rhitvik/Magnetic_Field_Pulse_Generator/Consideraton_Report_for_IC_LT8613/Simulation_Report_L&8613/Rhitvik Simulation report on LT8613.pdf

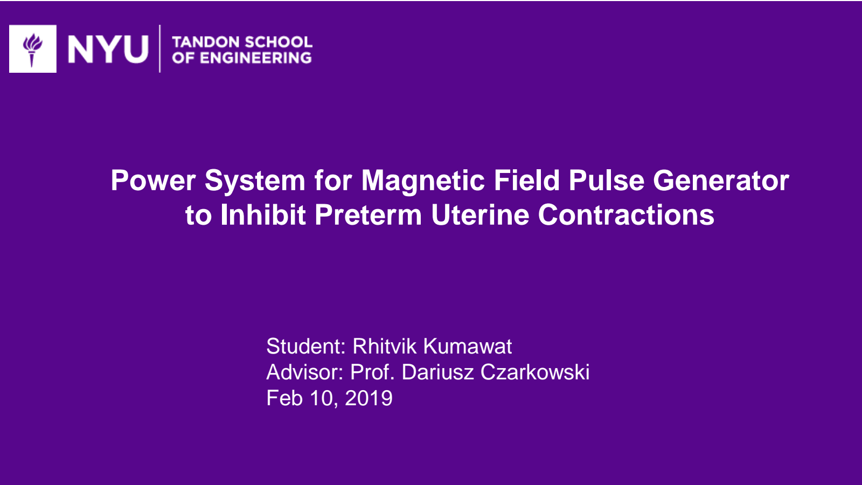
[picture p13: page 1]

# Power System for Magnetic Field Pulse Generator to Inhibit Preterm Uterine Contractions

## Student: Rhitvik Kumawat Advisor: Prof. Dariusz Czarkowski Feb 10, 2019

Basic Idea of Our Design

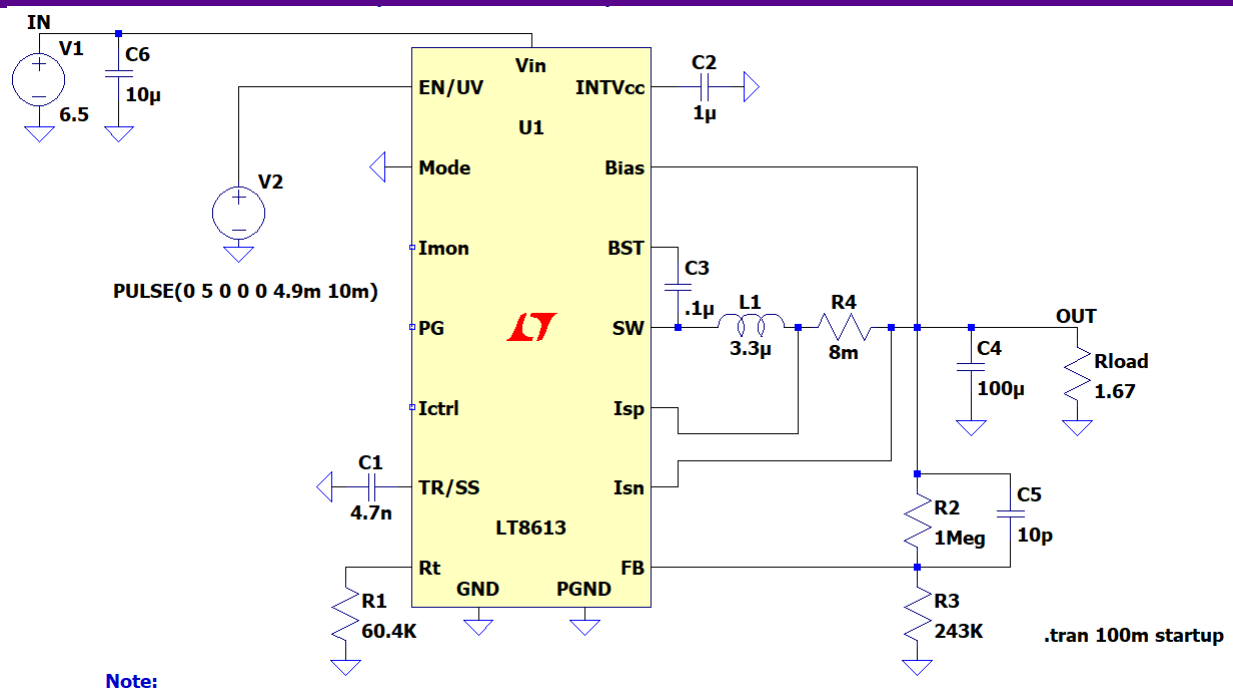
[picture p14: figure]

This is the IC configuration can be employed for our converter if we decide to go with LT8613

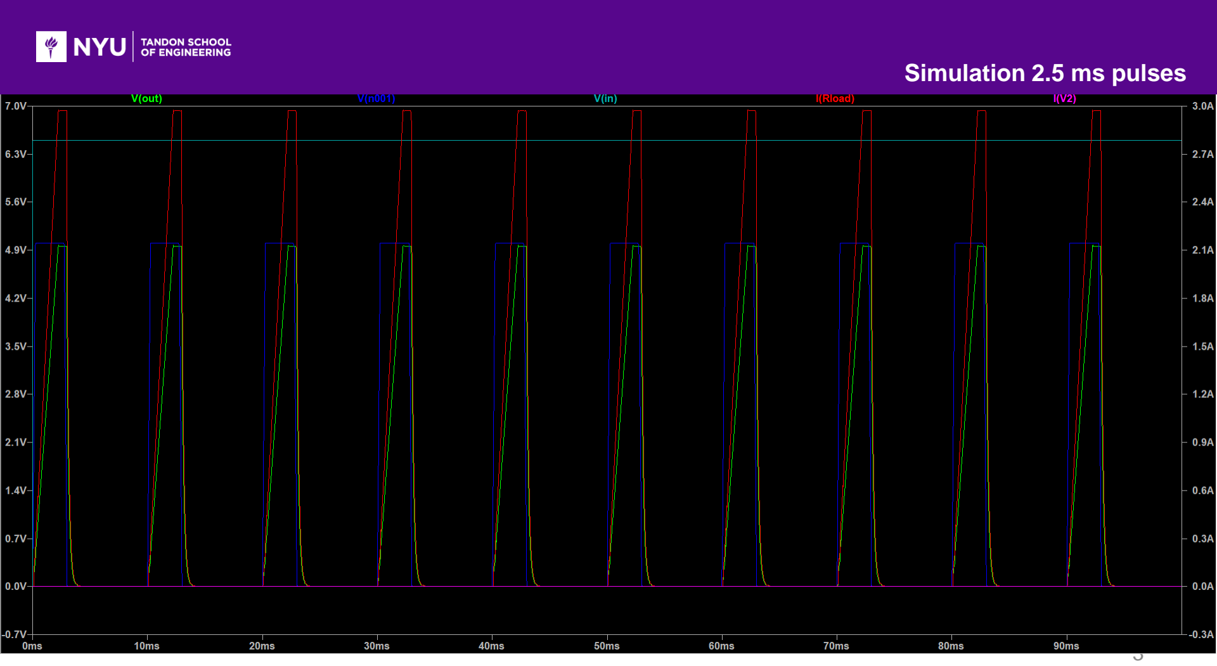
[picture p15: page 3]

Simulation 2.5 ms pulses

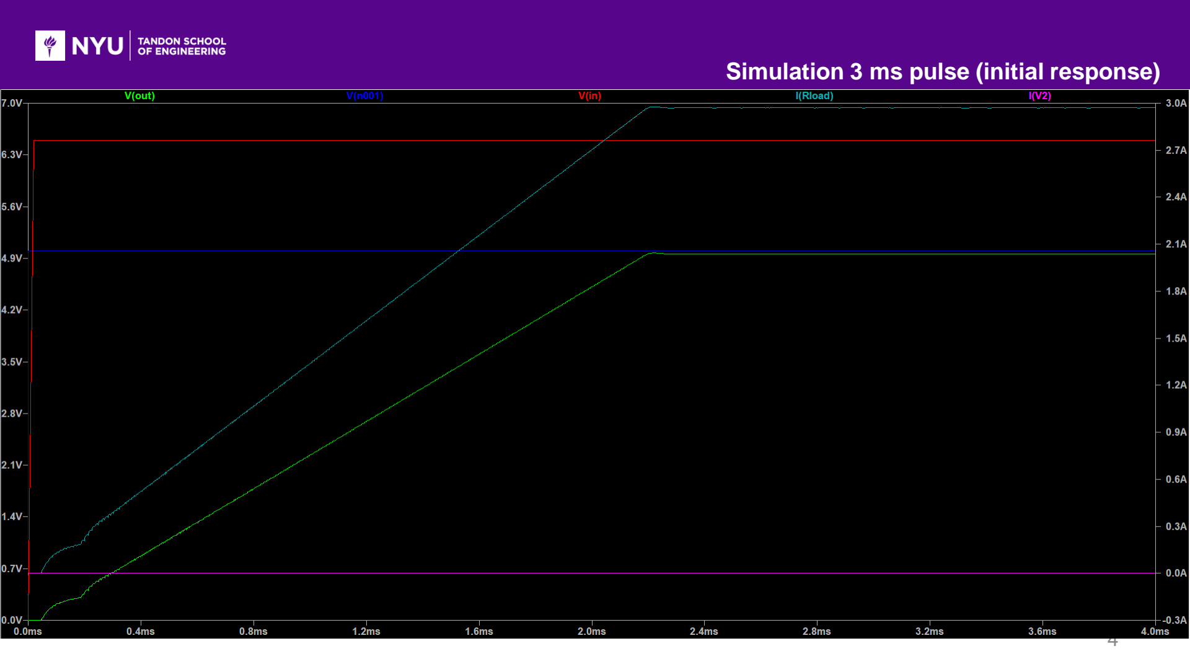
[picture p16: page 4]

Simulation 3 ms pulse (initial response)

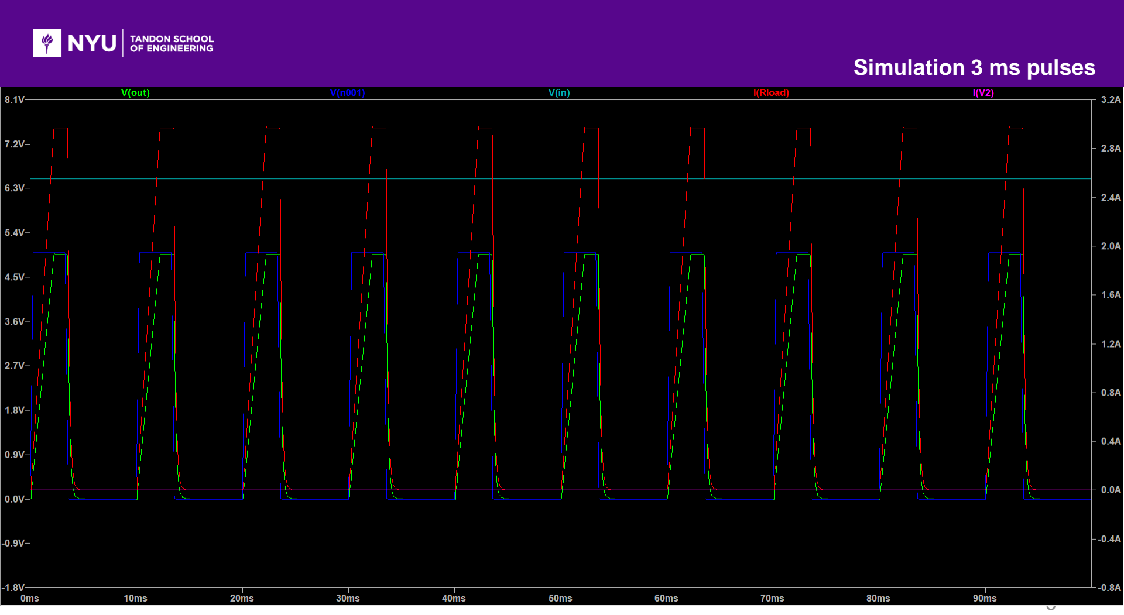
[picture p17: page 5]

Simulation 3 ms pulses

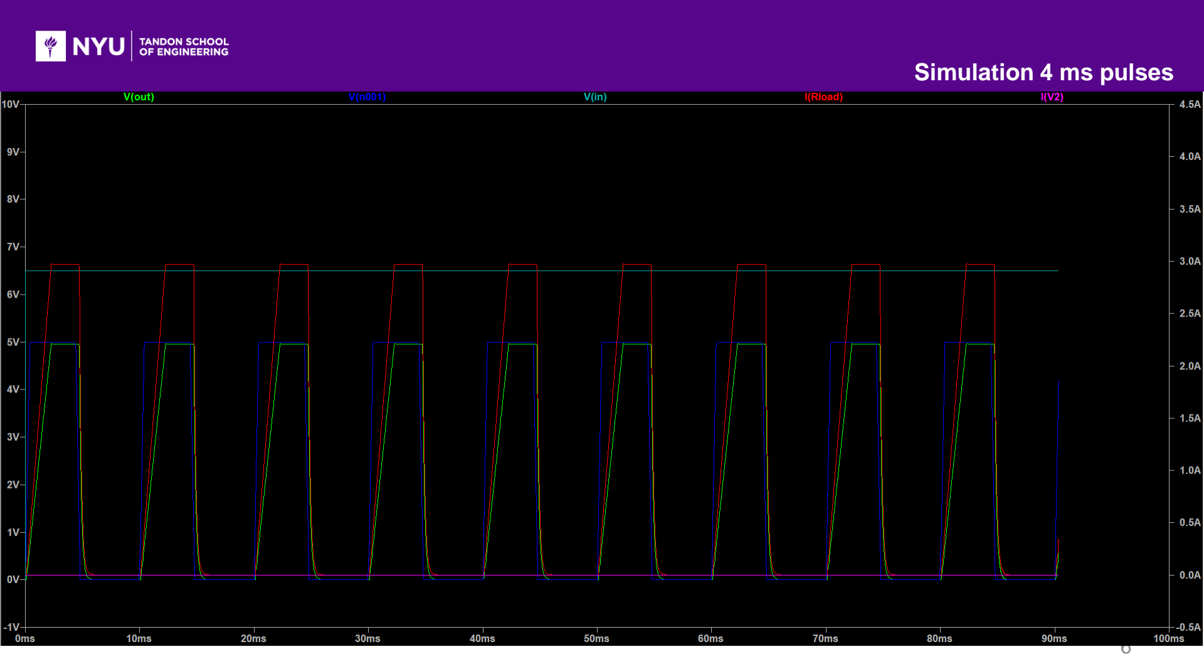
[picture p18: page 6]

Simulation 4 ms pulses

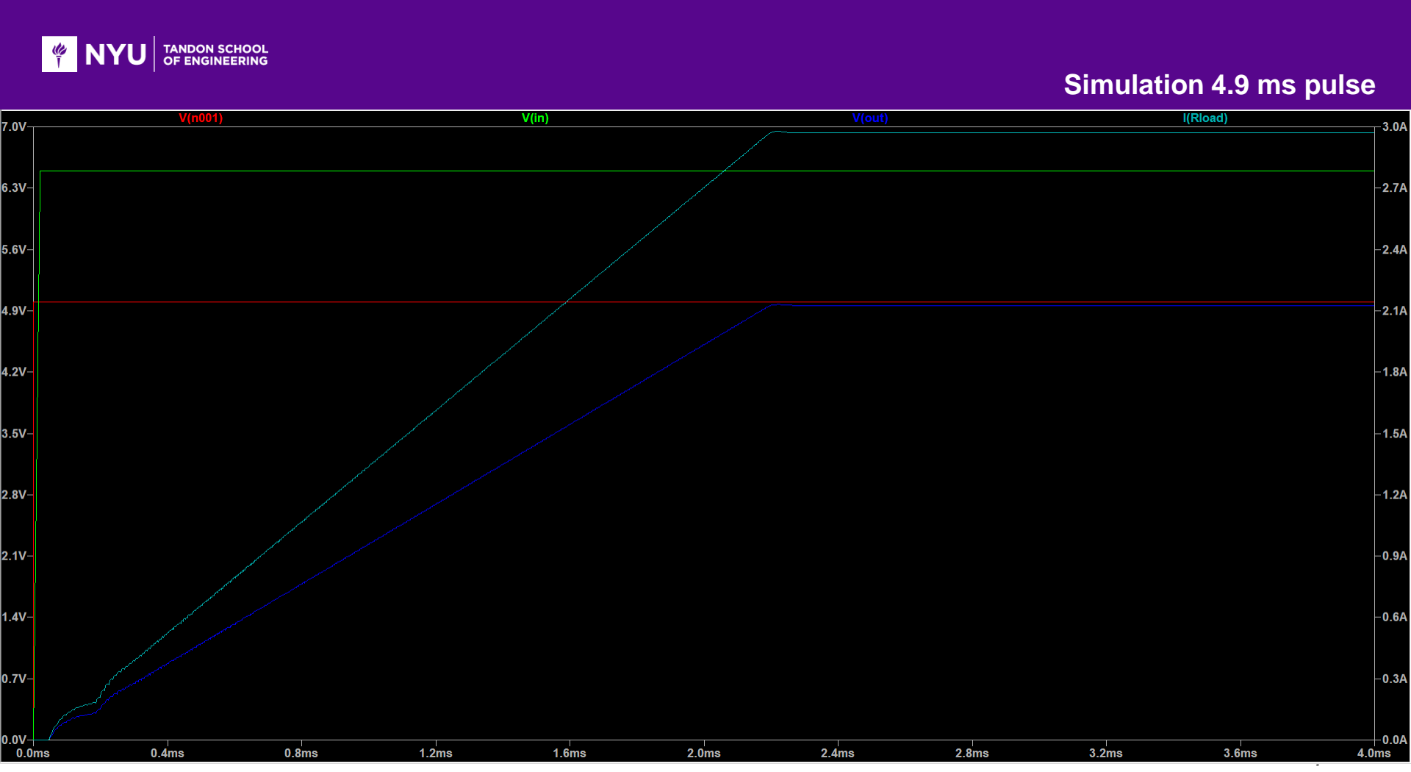
[picture p19: page 7]

Simulation 4.9 ms pulse

# End of Presentation Thank you
