rhitvik/Magnetic_Field_Pulse_Generator/Consideraton_Report_for_IC_LT8613/Images_and_Screeenshots/20171227142412_99787.png

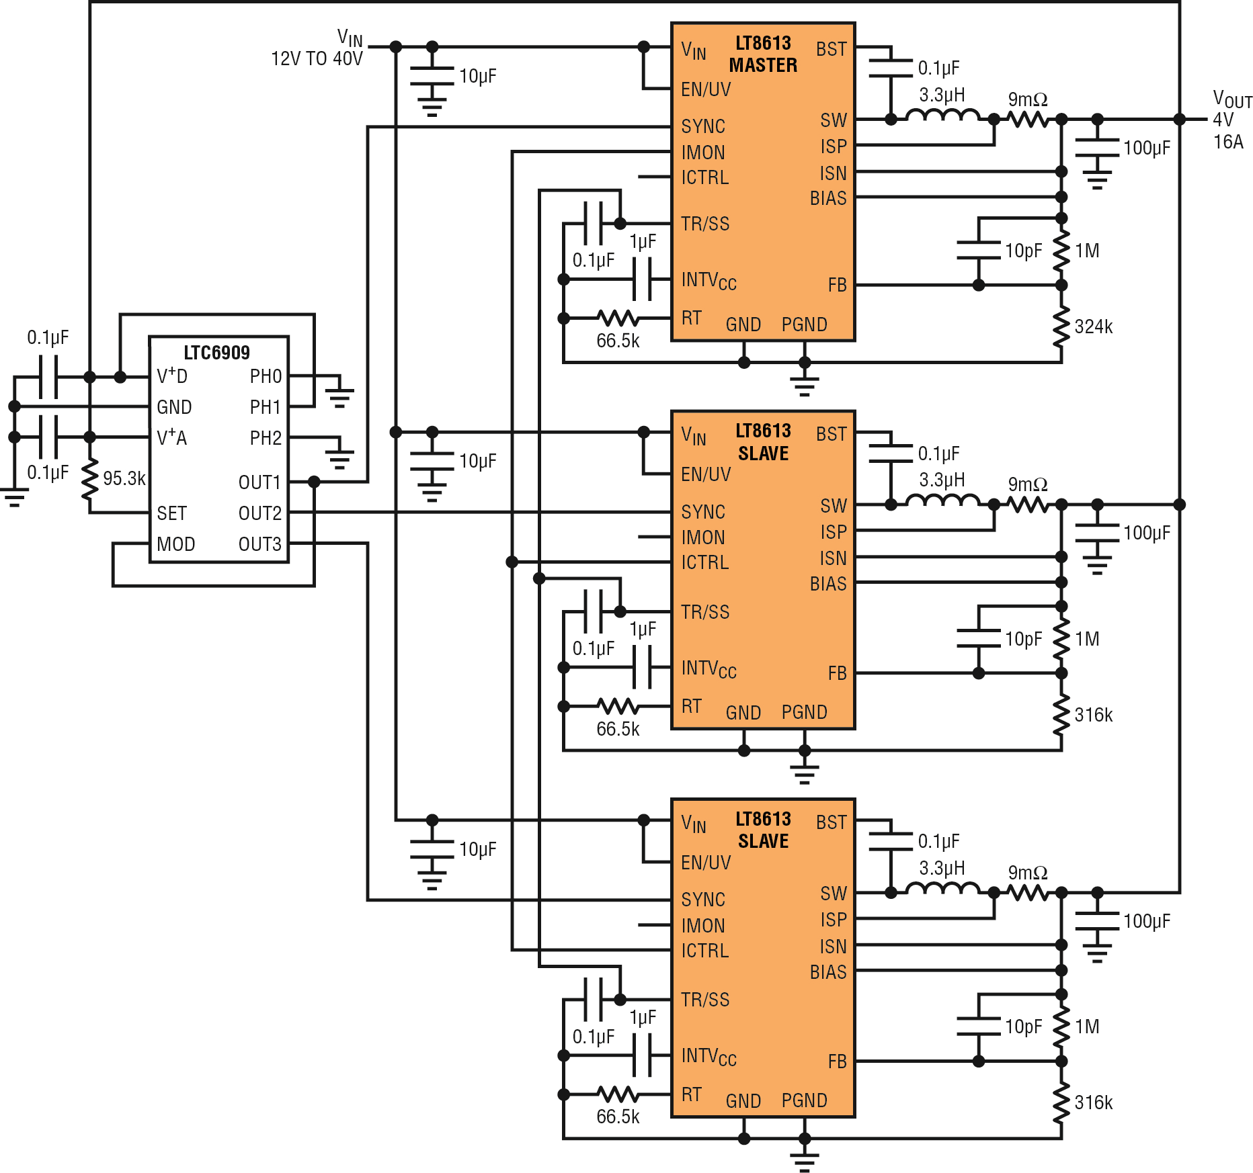
Consideraton_Report_for_IC_LT8613/Images_and_Screeenshots/20171227142412_99787.png
