rhitvik/Magnetic_Field_Pulse_Generator/Consideraton_Report_for_IC_LT8613/Images_and_Screeenshots/LT8613-32051.png

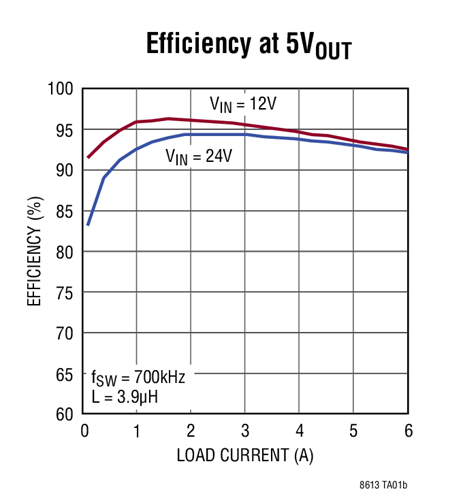
Consideraton_Report_for_IC_LT8613/Images_and_Screeenshots/LT8613-32051.png
