rhitvik/Magnetic_Field_Pulse_Generator/Images_and_Screenshots/Completed_Prototype.jpg

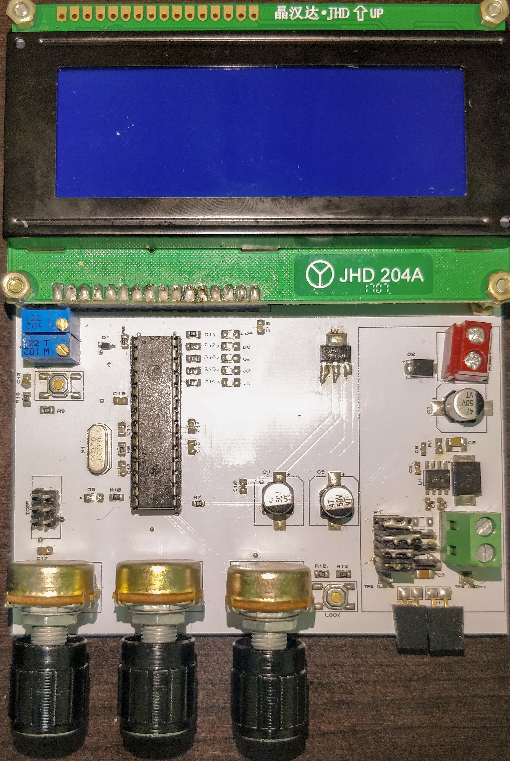
Images_and_Screenshots/Completed_Prototype.jpg
