rhitvik/Magnetic_Field_Pulse_Generator/Images_and_Screenshots/Obtained waveform.jpg

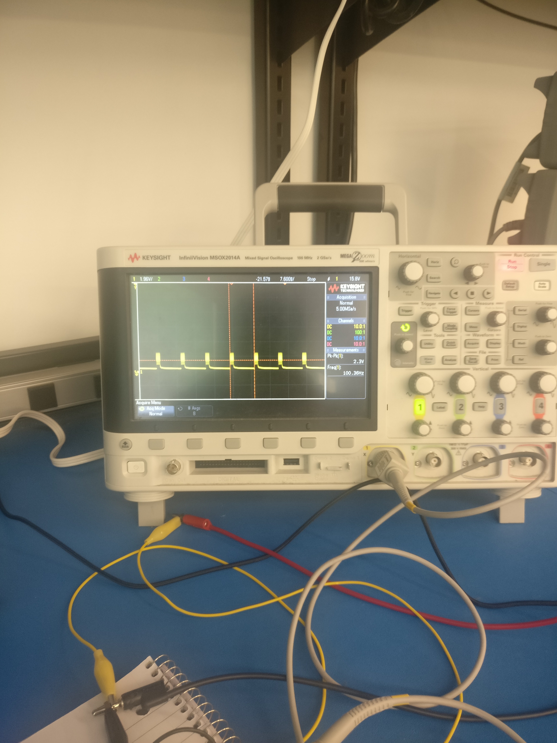
Images_and_Screenshots/Obtained waveform.jpg
