rhitvik/Magnetic_Field_Pulse_Generator/Images_and_Screenshots/PCB_for_the_Pulse_Generator.jpg

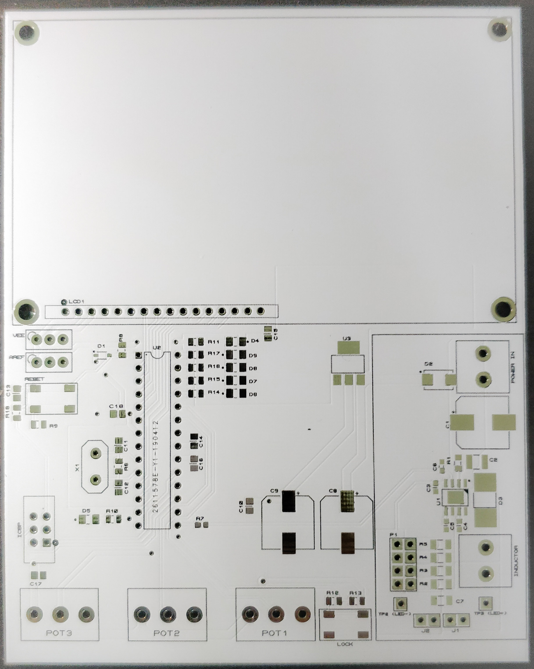
Images_and_Screenshots/PCB_for_the_Pulse_Generator.jpg
