rhitvik/Magnetic_Field_Pulse_Generator/Images_and_Screenshots/PSX_20190528_235512.jpg

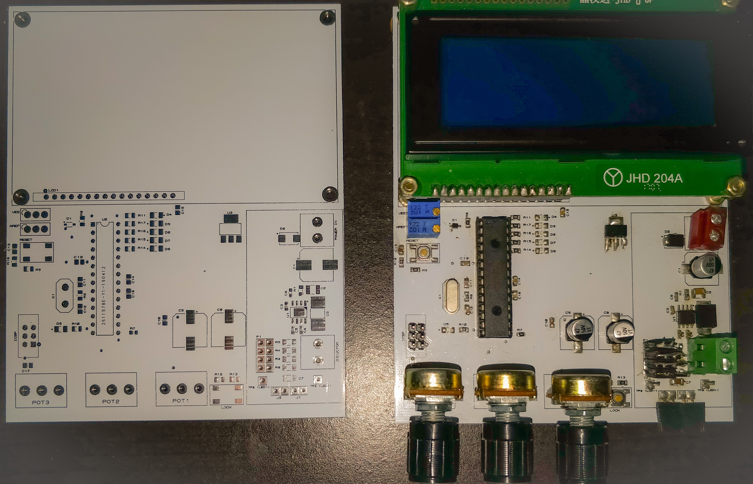
Images_and_Screenshots/PSX_20190528_235512.jpg
