rhitvik/Magnetic_Field_Pulse_Generator/Images_and_Screenshots/PSX_20190529_000846.jpg

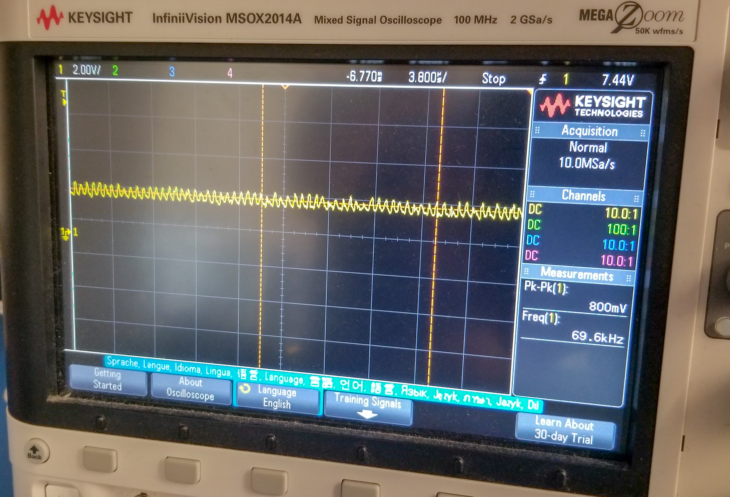
Images_and_Screenshots/PSX_20190529_000846.jpg
