rhitvik/Magnetic_Field_Pulse_Generator/Images_and_Screenshots/PSX_20190529_001306.jpg

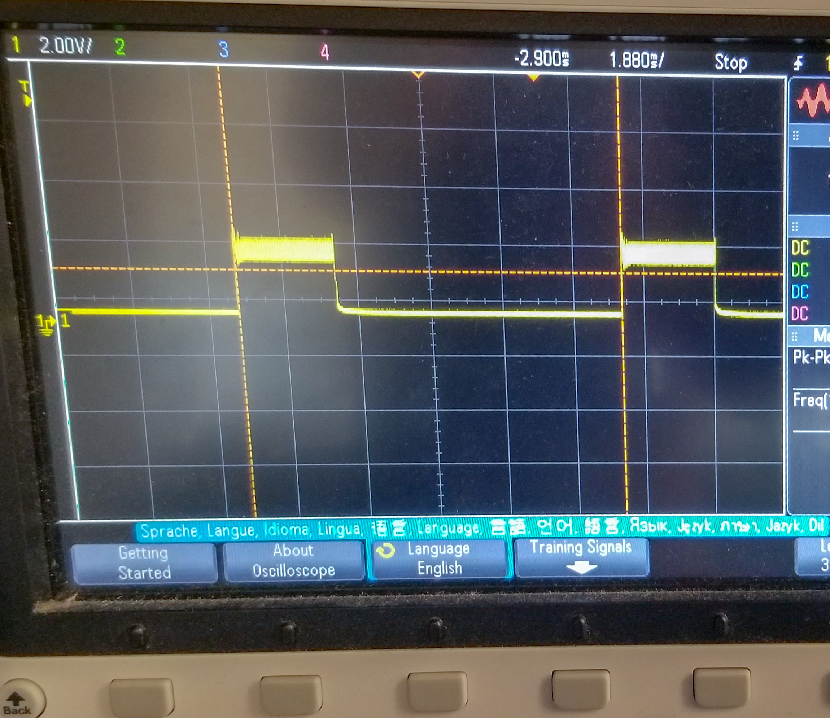
Images_and_Screenshots/PSX_20190529_001306.jpg
