rhitvik/Magnetic_Field_Pulse_Generator/Images_and_Screenshots/PSX_20190614_192414.jpg

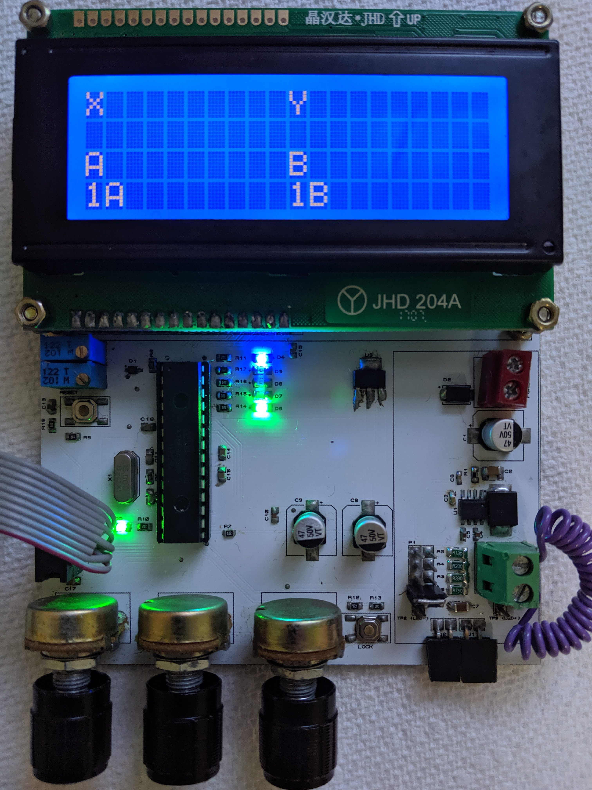
Images_and_Screenshots/PSX_20190614_192414.jpg
