rhitvik/Magnetic_Field_Pulse_Generator/Bill_of_materials/BOM - Revised.xlsx

Revision | 1
Design Created | 2019-03-28
Design Last Modified | 2019-04-07
Total Parts In Design | 65
0 Modules
Quantity | References | Value | Stock Code |  | Unit Cost
18 Capacitors
Quantity | References | Value | Stock Code | status | Unit Cost
3 | C1,C8,C9 | 47u |  | Delivered | 145 Pcs SMD Capacitors Assorted Box Kit $11.99 | https://www.amazon.com/Capacitors-Assorted-Values-Electrolytic-Assortment/dp/B0778LX66Z?s=gateway
1 | C2 | 1000pF | Digikey 478-1589-1-ND | Ordered | McIgIcM 1206 SMD Capacitor,16values20pcs=320pcs $15.99 | https://www.amazon.com/McIgIcM-16values20pcs-Electronic-Multiplayer-Capacitors/dp/B06XDHC93D?s=gateway
1 | C3 | 0.1u | Digikey C1608X7R1C104K/10-ND | Delivered | 90 Value x 50pcs = 4500pcs SMD $35.99 | https://www.amazon.com/WINGONEER-Capacitor-0-5pF-2-2uF-4500pcs-Sample/dp/B072FNVRKP?s=gateway
1 | C4 | 0.047u | Digikey PCC2286TR-ND | Delivered
1 | C5 | 0.1u | Digikey 478-1239-1-ND | Delivered
1 | C6 | 10n | Farnell 488-146 | Delivered
1 | C7 | 2.2u | Digikey 490-1815-2-ND | Ordered
1 | C10 | 0.47u | Digikey 478-1407-1-ND | Delivered
5 | C11,C12,C15,C16,C17 | 22pF | Digikey 478-1280-1-ND | Delivered
1 | C13 | 1.0u | Digikey 478-1409-1-ND | Delivered
2 | C14,C18 | 0.1u | Digikey 478-1395-1-ND | Delivered
18 Resistors
Quantity | References | Value | Stock Code |  | Unit Cost
1 | R1 | 63.5K / 27.4K | 72-0603 | Delivered | SMT 0603 Resistor and Capacitor Book - 3725 pieces $39.95 | https://www.adafruit.com/product/442
1 | R2 | 0.13 | Digikey 311-16.5FCT-ND | Ordered | 175 Value 1206 SMD Resistor Kit $21.84 | https://www.ebay.com/itm/175-Value-1206-SMD-Resistor-Kit-0R-10MR-1-4W-1-3500pcs-RoHS/302714233035
1 | R3 | 0.2 | Digikey 311-16.5FCT-ND | Ordered | Current Sense Resistors - SMD 1watt .2ohms 1% (5 pieces) $4.62 ($0.92 / Item) + $3.67 shipping | https://www.amazon.com/Current-Sense-Resistors-2ohms-pieces/dp/B0137MOWZ6?s=gateway
1 | R4 | 0.39 | Digikey 311-16.5FCT-ND | Ordered | Current Sense Resistors - SMD 1watts .39ohm 1% (5 pieces) $9.31 ($1.86 / Item) + $3.67 shipping | https://www.amazon.com/Current-Sense-Resistors-1watts-39ohm/dp/B00LWO20MY?s=gateway
1 | R5 | 0.75 | Digikey 311-16.5FCT-ND | Ordered | VISHAY DALE RCWE2010R750FKEA SMD Current Sense Resistors, AEC-Q200 RCWE Series, 0.75 ohm, 1 W, - 1% (5 pieces) Price: $9.08 ($1.82 / Item) + $3.67 shipping | https://www.amazon.com/VISHAY-RCWE2010R750FKEA-Current-Resistors-AEC-Q200/dp/B011NN7FPA?s=gateway
1 | R6 | 1.0M | Digikey P1.0MADKR-ND | Delivered | 2140Pcs SAMSUNG SMD 0805 50 Value Resistor & 32 Value Capacitor Assortment Kit $28.99 | https://www.amazon.com/2140Pcs-SAMSUNG-Resistor-Capacitor-Assortment/dp/B00BXXJBSA?s=gateway
1 | R7 | 1.00K | Digikey P1.00KHTR-ND | Delivered
1 | R8 | 10K | Digikey 311-10KADKR-ND | Delivered
2 | R9,R18 | 1K | Digikey P1.0KACT-ND | Delivered
2 | R10,R11 | 510 | Digikey 311-510CTR-ND | Delivered
1 | R12 | 4.7K | Digikey 311-4.70KCCT-ND | Delivered
1 | R13 | 10K | Digikey 311-4.70KCCT-ND | Delivered
4 | R14,R15,R16,R17 | 1K | Digikey 311-510CTR-ND | Delivered
2 Integrated Circuits
Quantity | References | Value | Stock Code |  | Unit Cost
1 | U1 | A6211 |  | Delivered | $15.97 (5 pieces) | https://www.amazon.com/FidgetFidget-5PCS-A6211GLJTR-T-8SOIC-A6211/dp/B07LBLMPG2?s=gateway
1 | U2 | ATMEGA328P |  | Delivered | Have it
0 Transistors
Quantity | References | Value | Stock Code |  | Unit Cost
9 Diodes
Quantity | References | Value | Stock Code |  | Unit Cost
1 | D1 | BAV19WS-7-F | Digikey BAV19WS-FDITR-ND | Delivered | $5.95 (50 pieces) | https://www.ebay.com/itm/BAV19WS-Diodes-2-5A-120V-200mW-Surface-Mount-Fast-Switching-50-pieces/123377312757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
1 | D2 | SMBJ20A | Digikey SMBJ20ALFTR-ND | Delivered | $5.00 (10 pieces) | https://www.ebay.com/itm/10-PCS-SMBJ20A-Diodes-Inc-Diode-TVS-Single-Uni-Dir-20V-600W-2-Pin-SMB/221852141761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
1 | D3 | B560C-13-F |  | Ordered | $3.74 + $3.09 Standard Shipping | https://www.ebay.com/itm/Diodes-B560C-13-F-Schottky-Diodes-60V-5A-case-SMC-5pcs/261211123832
6 | D4,D5,D6,D7,D8,D9 | LED-GREEN_0805_CONDITIONED |  | Delivered | $2.39 (20pcs) | https://www.ebay.com/itm/20pcs-0805-SMD-Blue-Super-Bright-LED-LEDs-Lamp-Light-Best-Price-Fast-US-Ship/253150288051
18 Miscellaneous
Quantity | References | Value | Stock Code |  | Unit Cost
1 | Quartz Crystal Oscillator | 16 Mhz |  | Delivered | $0.75 | https://www.adafruit.com/product/2215
1 | NCP1117 | 5V 1A | 1 | Delivered | AMS1117-5V Low Dropout Linear Voltage Regulator SOT-223 20pcs Price: $2.78 + $2.35 shipping | https://www.amazon.com/AMS1117-5V-Regulator-Motherboard-Optimus-Electric/dp/B072L4W7TK?s=gateway
1 | 20x4 LCD Display | 1 | 1 | Delivered | $6.13 | https://www.buydisplay.com/default/display-hd44780-compatible-20x4-lcd-module-bezel-white-on-blue
1 | Reset Button | 1 | 1 | Delivered | $5.86 | https://www.amazon.com/uxcell-5x5x1-5mm-Button-Tactile-Switch/dp/B07GMZCWXF?s=gateway
1 | ISP Port | 1 | 1 | Delivered | Have It
1 | Inline potentiometer | 2 | 2 | Delivered | Hilitchi 120-Pcs Multiturn Trimmer Potentiometer Assortment $17.86 | https://www.amazon.com/Hilitchi-120-Pcs-Multiturn-Potentiometer-Assortment/dp/B07146ZJJ3?s=gateway
1 | Volume Potentiometer | 1K |  | Delivered | uxcell 1K OHM Linear Taper Rotary Potentiometer 1KB B1K Pot 5 Pcs 3.99 | https://www.amazon.com/Uxcell-a15011600ux0213-Linear-Rotary-Potentiometer/dp/B0171M5SRE?s=gateway
1 | 2 Pin Terminal Connector | 1 |  | Delivered | 50 Pieces 2 Pin 5 mm Pinch PCB Mount Screw Terminal Block Connector 300V 10A (Green) $7.15 | https://www.amazon.com/Pieces-Pinch-Mount-Terminal-Connector/dp/B01MT4LC0F?s=gateway
1 | Breg Strip Male | 1 | 1 | Delivered | 60pcs Male and Female Pin Headers $8.99 | https://www.amazon.com/Headers-Arduino-Connector-Prototype-DEPEPE/dp/B07B2T3J1Y?s=gateway
1 | Breg strip Female | 1 | 1 | Delivered | included in male connectors | https://www.amazon.com/Headers-Arduino-Connector-Prototype-DEPEPE/dp/B07B2T3J1Y?s=gateway
1 | M3 Hex Brass Spacer Standoff Circuit Spacer | 3 | 3 | Ordered | 150pcs M3 Hex Brass Spacer Standoff Circuit Spacer $7.99 | https://www.amazon.com/ZYAMY-Standoff-Assortment-Mounting-Hardware/dp/B07CN3N8BS?s=gateway
1 | Pocket AVR programmer | 1 | 1 | Already Present | Have it
 | Solder Paste |  |  | Delivered | Solder Paste Sn42/Bi57.6/Ag0.4 No-Clean Lead-Free Low Temperature Melts 138C 281F $15.95 | https://www.amazon.com/Solder-Bi57-6-No-Clean-Lead-Free-Temperature/dp/B0195V1QEI?s=gateway
 | Solder flux |  |  | Delivered | LA-CO 22101 Regular Soldering Flux Paste, 2 oz $2.91 | https://www.amazon.com/22101-Regular-Soldering-Flux-Paste/dp/B005EO2HS0?s=gateway
 | Desoldering pump and Wick | 1 | 1 | Ordered | Tabiger Solder Wick & Desoldering Pump, Solder Sucker & Desoldering Wick, 2pcs Solder Braid (2.5mm Width, 1.5m Length)- Desoldering Vacuum Pump Solder Remover $8.98 | https://www.amazon.com/Tabiger-Solder-Desoldering-Sucker-Remover/dp/B0777LMVTT?s=gateway
1 | Anti-static ESD Tweezer Kit | 1 | 1 | Delivered | Vastar Tweezers - 12 Pieces Precision Tweezers Set Anti-static ESD Tweezers Kit $13.99 | https://www.amazon.com/Vastar-Tweezers-Precision-Anti-static-Non-magnetic/dp/B07K126S4K?s=gateway
Totals: |  |  |  |  | $295.77
2019-04-07 10:50
