rhitvik/Magnetic_Field_Pulse_Generator/Images_and_Screenshots/PCB_noComponents_Back.PNG

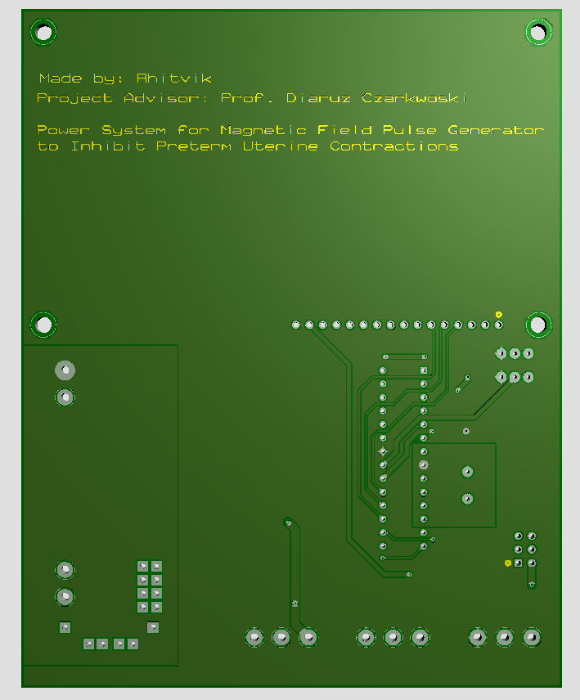
Images_and_Screenshots/PCB_noComponents_Back.PNG
