rhitvik/Magnetic_Field_Pulse_Generator/Images_and_Screenshots/PCB_noComponents_Front.PNG

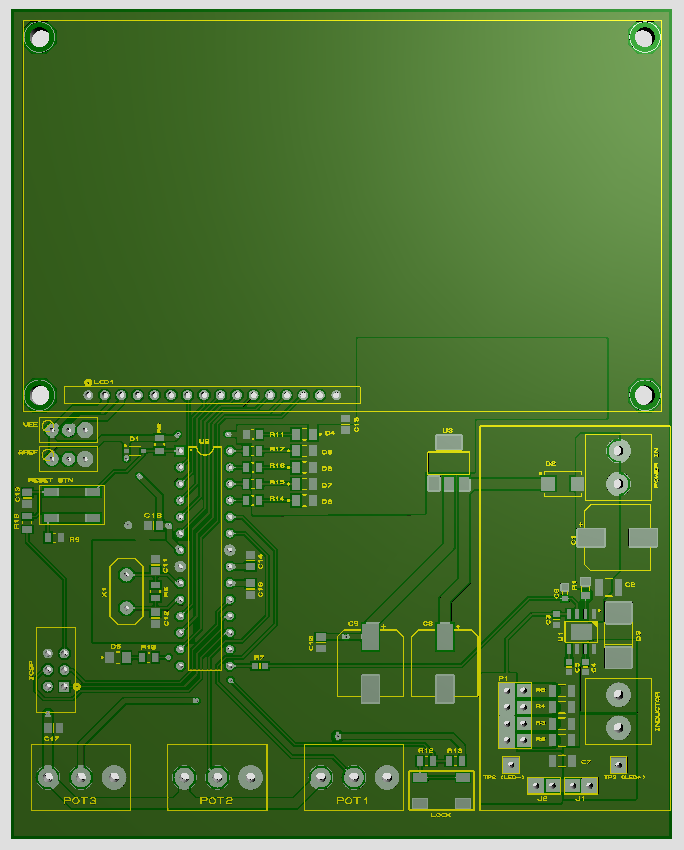
Images_and_Screenshots/PCB_noComponents_Front.PNG
