rhitvik/Magnetic_Field_Pulse_Generator/Images_and_Screenshots/According to evaluation board.PNG

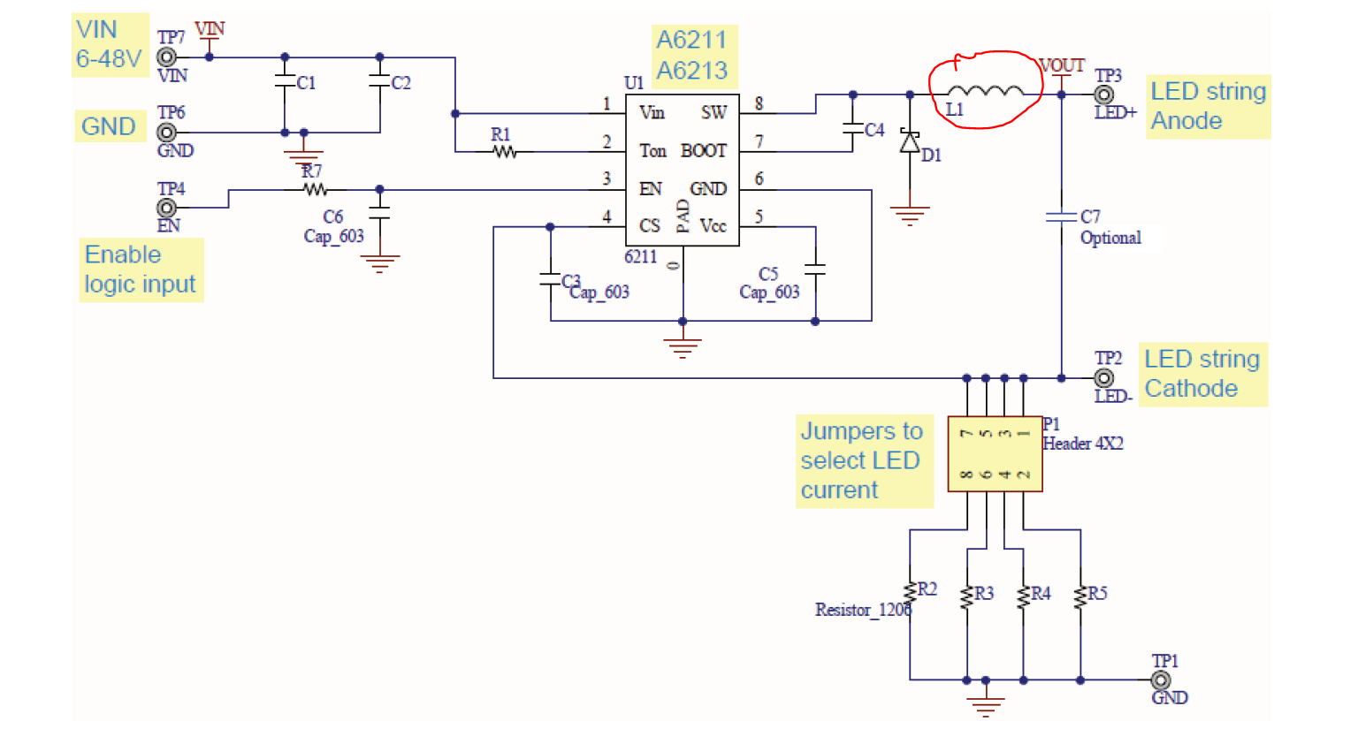
Images_and_Screenshots/According to evaluation board.PNG
