rhitvik/Magnetic_Field_Pulse_Generator/Images_and_Screenshots/Evaluation_Board_Design.jpg

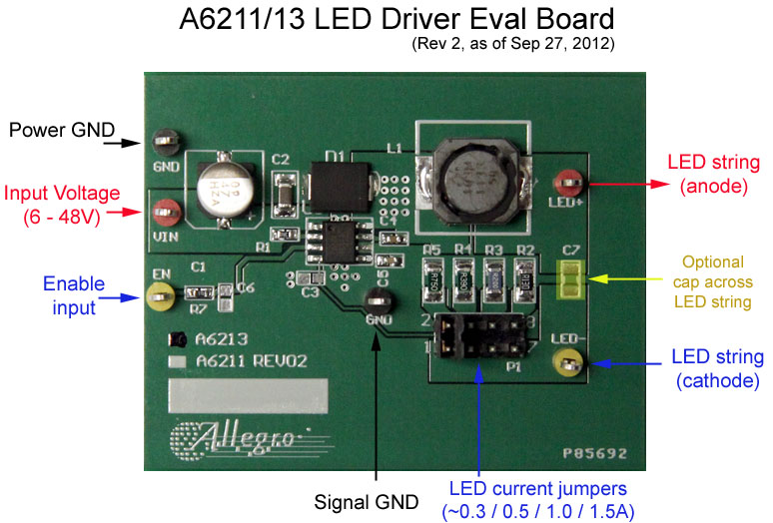
Images_and_Screenshots/Evaluation_Board_Design.jpg
