rhitvik/Magnetic_Field_Pulse_Generator/Consideraton_Report_for_IC_LT8613/Simulation_Report_L&8613/lt8613_dc2011_ta01 Default.asc

C1: cap; 4.7n
C2: cap; 1µ
C3: cap; .1µ
C4: cap; 100µ; V=6.3 Irms=0 Rser=0.002 Lser=0
C5: cap; 10p
C6: cap; 10µ
L1: ind; 3.3µ; Ipk=8 Rser=0.0199 Rpar=0 Cpar=0
R1: res; 60.4K
R2: res; 1Meg
R3: res; 243K
R4: res; 8m
Rload: res; 1.67
U1: LT8613
V1: voltage; 12
Named nets: 0, OUT, IN
.tran 4m startup
LT8613 - 42V, 6A Synchronous Step-Down Regulator with Current Sense and 3µA Quiescent Current
5V Step-Down Converter with 6A Output Current Limit
Input: 5.8V to 42V      Output: 5V @ 6A, Fsw = 700kHz
Note:
  If the simulation model is not found please update with the "Sync Release" command from the "Tools" menu.
  It remains the customer's responsibility to verify proper and reliable operation in the actual application.
  Component substitution and printed circuit board layout may significantly affect circuit performance or reliability.
  Contact your local sales representative for assistance. This circuit is distributed to customers only for use with LTC parts.
  Copyright © 2015 Linear Technology Inc. All rights reserved.
