rhitvik/Magnetic_Field_Pulse_Generator/(list of files, drawings)

Other design files:
Schematic&PCB_layout/Buck_converter_pcb.pdsprj
